PaulaMarquezM/Reci/tests/fotos_dificiles/gatorade_vidrio_473ml.jpeg

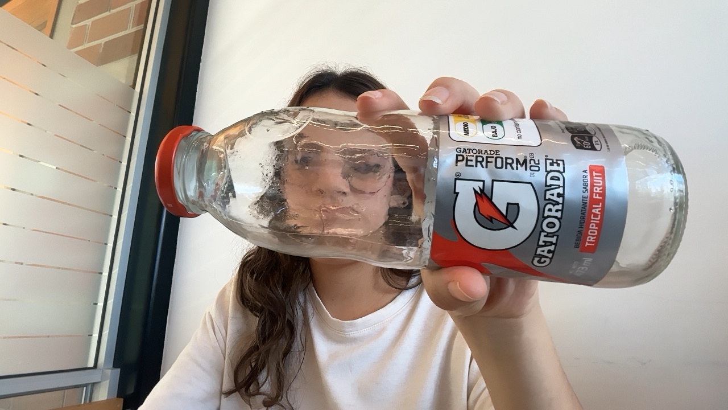
tests/fotos_dificiles/gatorade_vidrio_473ml.jpeg
