PaulaMarquezM/Reci/docs/product/PLAN.md

# Reci — Plan maestro

> Documento vivo. Se actualiza cada vez que cerramos una fase o cambiamos una decisión.
> Última actualización: 2026-07-22 · RECI2 integrado en el monorepo RECI; Fase 6 en curso, Fase 3 desbloqueada.

Este documento responde a tres preguntas en orden:

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

---

## Estado actual

### Hecho

- ✅ Acta de constitución aprobada (RECI-2026-PI v1.0).
- ✅ Repositorio principal: [`AxelJhostin/RECI`](https://github.com/AxelJhostin/RECI), con el historial de `PaulaMarquezM/Reci` importado.
- ✅ Monorepo: `web/`, `firmware/`, `services/`, `expert_system/`, `vision/` y `docs/`.
- ✅ `web/` scaffolded con **Next.js 16.2 + React 19 + Tailwind 4 + TypeScript** (App Router, Turbopack, `src/` layout). Build y lint limpios.
- ✅ Landing en español (`/`) con el branding Reci y las funcionalidades destacadas.
- ✅ Proyecto Supabase creado + schema v1 aplicado (12 tablas, triggers de puntos/racha, RLS).
- ✅ Cliente Supabase tipado (`web/src/lib/supabase/`), middleware de sesión, Auth magic link.
- ✅ Página `/login` y ruta `/app` protegida funcionando.
- ✅ 8 API routes implementadas (recycle, robot position, calls, coupons, compartments, face, vision/classify).
- ✅ Hardware final definido: Arduino Mega 2560 + ESP32-CAM (ver decisiones técnicas).
- ✅ Guía de conexiones de hardware documentada (`docs/product/CONEXIONES.md`), orden de ensamble por etapas para Leonela + Andrea.
- ✅ Las 5 pantallas de la app (home/mapa, llamar, historial, cupones, ajustes) conectadas a las API routes.
- ✅ Rediseño visual: tipografía Poppins, paleta cream/ink, mascota de Reci (`web/src/components/reci-mascot.tsx`).
- ✅ PWA instalable: `manifest.ts` + iconos generados dinámicamente con `next/og` (`icon-192.png`, `icon-512.png`, `icon-maskable-512.png` con safe-zone para Android adaptive icons).
- ✅ `services/vision` implementado (FastAPI + Claude/Gemini/OpenAI + heurísticas y sistema experto compartidos) y conectado a `/api/vision/classify`. Ver [`DECISION-SERVICIO-VISION.md`](DECISION-SERVICIO-VISION.md). Probado localmente; falta desplegarlo y probarlo con la ESP32-CAM física.

### En curso

- **Fase 5 completada** — backend y nube listos para integrarse con el hardware.
- **Fase 6 en curso** — pantallas y rediseño visual listos, PWA instalable lista. Falta: service worker (offline) y push notifications (marcado "soon" en `/app/ajustes`).
- **Fase 3 desbloqueada** — clasificación real disponible vía `services/vision`; falta desplegarlo y validar con fotos de la ESP32-CAM real (ver Fase 3 en el roadmap).

### Bloqueado / pendiente de decidir

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

> Resuelto: proveedor de mapas → **Leaflet + OSM** (implementado en Fase 6, sin token).

---

## Decisiones técnicas

Las decisiones del acta dejaban algunos "A o B" abiertos. Esto es lo que cerramos:

| Tema | Decisión | Razón |
| --- | --- | --- |
| Stack de la app | **Next.js PWA + Tailwind** | Un solo repo / stack para app + dashboard admin. Sin App Store/Play Store. La app vive como PWA instalable. |
| Stack del backend | **Supabase + Next.js API routes** | Auth, Postgres, Realtime y Storage en un solo proveedor. Sin servidor adicional que mantener. |
| Estructura del repo | Monorepo simple con carpetas por subsistema (`web/`, `firmware/`, `services/`, `expert_system/`, `vision/`) | Cada persona trabaja en su carpeta sin pisar al resto. Una sola fuente de verdad. |
| Versión de Next | **Next 16.2** (lo que instaló `create-next-app` hoy) | Tiene Turbopack estable y React 19. La doc local en `node_modules/next/dist/docs/` es la fuente autoritativa porque trae breaking changes vs Next 15. |
| Idioma de la UI | Español (Ecuador) | Es para el campus PUCE Manabí. Solo el código y los commits van en inglés. |
| Hosting | **Vercel** para el front + Supabase Cloud para DB | Deploy automático desde main. Free tier alcanza para el piloto. |
| **Cerebro del robot** | **Arduino Mega 2560** (era ESP32) | Más pines y memoria. Controla motores (2×L298N), servos (2×SG5010), sensores HC-SR04 y OLED. |
| **Sistema de visión** | **ESP32-CAM + OV2640** (era Raspberry Pi 4) | Sin Raspberry Pi. La ESP32-CAM captura imagen y la envía al cloud via WiFi. La IA corre en el servidor, no en el robot. |
| **Inferencia IA** | **Servicio Python aislado (`services/vision`), llamado desde `/api/vision/classify`** (era "dentro del Route Handler de Next.js con TF.js/ONNX") | Mismo patrón que `face-service`. Reutiliza directamente el sistema experto y los proveedores visuales compartidos y probados en este monorepo (117/117 pruebas del SE, 39/39 capturas reales con Claude) en vez de esperar al dataset propio + conversión a TF.js/ONNX. Ver [`DECISION-SERVICIO-VISION.md`](DECISION-SERVICIO-VISION.md). El MobileNetV2 propio con fotos de la ESP32-CAM sigue el plan, pero como mejora dentro de ese mismo servicio, no como bloqueante del Flujo A. |
| **Comunicación interna** | **UART Serial entre ESP32-CAM y Arduino Mega** (era UART Raspberry↔ESP32) | Protocolo `CMD:<accion>:<param>\n`. La ESP32-CAM recibe la decisión del cloud y la reenvía al Arduino. |
| **Despacho de llamadas al robot** | **Polling HTTP cada 3s** (era "webhook o canal Realtime") | El webhook necesita que el robot sea alcanzable desde internet, y va a estar detrás del NAT del WiFi del campus sin IP pública. Realtime es WebSocket+TLS+protocolo Phoenix sobre un ESP32-CAM que ya tiene la RAM comida por el framebuffer de la cámara: frágil. Polling es aburrido, funciona detrás de NAT y para "ven a buscarme" 3s de latencia nadie los nota. Contrato en [`API-ROBOT.md`](API-ROBOT.md). |
| **Posición del robot** | **Simbólica por punto, sin GPS** | No hay GPS en el BOM y Reci solo se mueve entre puntos fijos. Reporta `point_id` y el cloud resuelve lat/lng desde `robot_points`. Cero hardware nuevo y el mapa no cambia. Un NEO-6M daría 2–5m de error entre edificios y nada bajo techo: no vale la integración. |
| **Llave del robot** | **`ROBOT_API_KEY` propia** (era la service role key) | El firmware va grabado en un aparato que vive en el campus y se puede desarmar, así que esa llave hay que darla por comprometida. La service role key se salta todo el RLS: con ella se lee la tabla de usuarios entera. La llave del robot solo abre las 4 rutas del robot y se revoca sola. |
| **Energía** | **Power Bank 10,000 mAh** (lógica) + **LiPo** (motores) + **LM2596** (regulador) | Separación de circuitos para evitar interferencias y proteger la electrónica. |

---

## Roadmap por fases

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

### Fase 1 — Diseño y planificación · semanas 1–2

**Objetivo:** todo el equipo entiende lo mismo y existe arquitectura detallada antes de teclear código.

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

### Fase 2 — Prototipo físico base · semanas 3–4

**Objetivo:** un chasis que se mueve entre dos puntos sin compuertas ni IA.

- [ ] **Leonela** · ensamble chasis + ruedas + 2×L298N + 4 motorreductores TT
- [ ] **Leonela** · firmware Arduino Mega base: `forward / backward / stop / turn`
- [ ] **Leonela** · sensores HC-SR04 con parada automática a ≤ 20 cm
- [ ] **Leonela** · pantalla OLED 0.96" I2C mostrando estado del robot — la cara de Reci ya está escrita en `firmware/arduino-mega/Display.h` (`CMD:FACE:<estado>`), falta probarla contra el OLED real
- [ ] **Andrea** · Power Bank (lógica) + LiPo (motores) + LM2596 (regulador) + cableado
- [ ] **Andrea** · prueba de movimiento punto-a-punto sobre cinta marcada

### Fase 3 — Sistema IA y experto · semanas 4–6

**Objetivo:** clasificación vidrio/plástico ≥ 85% en condiciones del campus, corriendo en el cloud.

- [x] **`services/vision` implementado** — FastAPI + Claude/Gemini/OpenAI + heurísticas y sistema experto compartidos, probado localmente (auth, validación, manejo de errores, mapeo a `MaterialType`). Ver [`DECISION-SERVICIO-VISION.md`](DECISION-SERVICIO-VISION.md).
- [x] **`web/src/app/api/vision/classify/route.ts`** — stub reemplazado, llama a `services/vision` vía `web/src/lib/vision/service.ts` (mismo patrón que `face/service.ts`). Falla segura a `desconocido` si el servicio no responde.
- [ ] **Axel/Andrea** · desplegar `services/vision` en un host accesible desde Vercel y configurar `VISION_SERVICE_URL` / `VISION_SERVICE_API_KEY` en el panel de Vercel
- [ ] **Axel + Paula** · prueba end-to-end: ESP32-CAM → `POST /api/vision/classify` → `services/vision` → respuesta JSON, con fotos reales de la ESP32-CAM
- [ ] **Axel** · recalibrar `visual_heuristics.py` con fotos reales de la ESP32-CAM (320×240) — los umbrales actuales vienen de fotos de mayor resolución del laboratorio de IA
- [ ] **Axel** (mejora, no bloquea) · captura del dataset propio (≥ 500 imgs por clase) en el campus con ESP32-CAM, para entrenar un MobileNetV2 que corra como primer voto dentro de `vision-service` — optimización de costo/latencia sobre Claude/Gemini, no reemplazo

### Fase 4 — Integración Reci físico · semanas 6–8

**Objetivo:** el robot completo funciona con el cloud (ESP32-CAM → cloud → Arduino Mega).

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

### Fase 5 — Backend y nube · semanas 7–10

**Objetivo:** API y base de datos listas para que la app y el robot conversen.

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

### Fase 6 — App móvil · semanas 9–12

**Objetivo:** la app es usable end-to-end.

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

### Fase 7 — Integración end-to-end · semanas 12–14

**Objetivo:** los 3 flujos (A, B, C del acta) funcionan sin intervención manual.

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

### Fase 8 — Piloto en campus + cierre · semanas 14–16

**Objetivo:** Reci opera en el campus durante una semana y entregamos el proyecto.

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

---

## Backlog por subsistema

### Cloud + App/PWA · Paula

Schema mínimo v1 a crear en Supabase (Fase 5):

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

Endpoints REST mínimos (Next.js Route Handlers en `web/src/app/api/`):

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

### Firmware · Leonela + Andrea

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

**ESP32-CAM** (C++ Arduino, AI Thinker):
- Al recibir `C` por el Monitor Serial: toma 3 fotos con flash (`kFlashLedPin`), llama a `POST /api/vision/classify` por cada una (`record_event: false`) y vota mayoría localmente.
- Registra el resultado final una sola vez con `POST /api/events/recycle`; si la respuesta trae `claim_code`, lo reenvía al Mega como `CMD:QR:<code>`.
- Reconocimiento facial (saludo) es un flujo aparte, contra `/api/face/recognize` — ver `services/face`.

### IA · Axel

- Servicio aislado `services/vision` (FastAPI), llamado desde `web/src/app/api/vision/classify/route.ts` — mismo patrón que `services/face`. Ver [`DECISION-SERVICIO-VISION.md`](DECISION-SERVICIO-VISION.md).
- Clasificación con Claude/Gemini/OpenAI (9 atributos) + heurísticas compartidas, probada en este monorepo (117/117 pruebas del sistema experto, 39/39 capturas reales).
- Sistema experto de 193 reglas (CF MYCIN, meta-reglas, forward + backward chaining) sobre los atributos extraídos — no reglas IF-THEN simples sobre un solo umbral.
- Pendiente (mejora, no bloqueante): MobileNet v2 propio entrenado con dataset de la ESP32-CAM, corriendo dentro de `vision-service` como primer voto (reduce costo/latencia de las llamadas a Claude/Gemini).
- Sin procesamiento local en el robot — toda la inferencia ocurre en el cloud (la ESP32-CAM solo captura y envía).

---

## Métricas de éxito (recordatorio del acta)

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

---

## Próximos pasos inmediatos

Por orden:

1. **Paula** — 🔴 **levantar los puntos fijos del campus con el Decanato y cargarlos en `robot_points`.** Es barato (una tarde con un GPS de celular) y desbloquea todo el Flujo B, que hoy está escrito y sin poder probarse.
2. **Paula** — aplicar `20260716000001_robot_calls_dispatch.sql` en Supabase y poner `ROBOT_API_KEY` en Vercel.
3. **Paula** — la app reacciona por Realtime a "Reci aceptó / llegó" en `/app/llamar`.
4. **Andrea** — cliente HTTP en la ESP32-CAM contra [`API-ROBOT.md`](API-ROBOT.md); el contrato ya está cerrado, no hace falta esperar a la IA.
5. **Paula** — service worker (PWA offline), opt-in facial y push notifications (cierre de Fase 6).
6. **Axel/Andrea** — desplegar `services/vision` en un host accesible desde Vercel y configurar `VISION_SERVICE_URL`/`VISION_SERVICE_API_KEY`; ya no bloquea al Flujo A (el servicio existe y está probado localmente, ver [`DECISION-SERVICIO-VISION.md`](DECISION-SERVICIO-VISION.md)), pero falta correrlo con fotos reales de la ESP32-CAM.
7. **Axel** — captura del dataset propio con ESP32-CAM y transfer learning de MobileNet v2 (Fase 3), ahora es una mejora de costo/latencia dentro de `vision-service`, no el bloqueante del Flujo A.
8. **Leonela + Andrea** — ensamble físico siguiendo `docs/product/CONEXIONES.md` (Fase 2 → Fase 4).
