PaulaMarquezM/Reci/firmware/esp32-cam/ReciEsp32Cam/ReciHttpClient.h

// ============================================================
// RECI · Cliente HTTP/HTTPS para la ESP32-CAM
// ============================================================

#ifndef RECI_HTTP_CLIENT_H
#define RECI_HTTP_CLIENT_H

#include <Arduino.h>
#include <WiFiClient.h>
#include <WiFiClientSecure.h>

// GTS Root R1, raíz vigente de la cadena TLS usada por *.vercel.app.
// Fuente oficial: https://pki.goog/roots.pem
static const char kReciTlsRootCa[] PROGMEM = R"RECI_CERT(
-----BEGIN CERTIFICATE-----
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
bP6MvPJwNQzcmRk13NfIRmPVNnGuV/u3gm3c
-----END CERTIFICATE-----
)RECI_CERT";

class ReciHttpClient {
 public:
  explicit ReciHttpClient(const String& url) {
    if (url.startsWith("https://")) {
      secureClient_.setCACert(kReciTlsRootCa);
      client_ = &secureClient_;
    } else {
      client_ = &plainClient_;
    }
  }

  NetworkClient& get() { return *client_; }

 private:
  WiFiClient plainClient_;
  NetworkClientSecure secureClient_;
  NetworkClient* client_ = nullptr;
};

#endif  // RECI_HTTP_CLIENT_H
