PaulaMarquezM/Reci/firmware/arduino-mega/ReciRutaDemo/ReciRutaDemo.ino

// ============================================================
// RECI · Ruta demo sin sensores de linea
// Arduino Mega 2560 + 2 L298N + 4 motores TT
//
// Ruta recta de demostración: BASE <-> P1 <-> P2
// RECI no gira: hacia P1/P2 avanza y hacia BASE regresa en reversa por la
// misma línea. En reversa frena con el ultrasónico trasero (D26/D27).
//
// IMPORTANTE
// - Este sketch NO se mueve al encender.
// - Coloca siempre el robot en BASE antes de probar una ruta.
// - Prueba primero con las ruedas levantadas.
// - Ajusta los tres tiempos de ruta despues de medir el circuito real.
// ============================================================

#include <Wire.h>
#include <Adafruit_GFX.h>
#include <Adafruit_SSD1306.h>
#include <LiquidCrystal_I2C.h>
#include <Servo.h>
#include <EEPROM.h>
#include <qrcode.h>

namespace {

// Mapa confirmado por RECI_Guia_Armado_Electronico.docx.
constexpr uint8_t kIzqIn1 = 5;
constexpr uint8_t kIzqIn2 = 6;
constexpr uint8_t kIzqIn3 = 7;
constexpr uint8_t kIzqIn4 = 8;
constexpr uint8_t kDerIn1 = 9;
constexpr uint8_t kDerIn2 = 10;
constexpr uint8_t kDerIn3 = 11;
constexpr uint8_t kDerIn4 = 13;

// Sentido de cada motor por separado. Si con F una rueda gira hacia atrás,
// cambia SOLO la constante de ese par de pines. Para saber qué rueda mueve
// cada par, escribe MOTORES en el Monitor Serial (con las ruedas levantadas).
constexpr bool kInvertirIzqA = true;   // D5/D6
constexpr bool kInvertirIzqB = true;   // D7/D8
constexpr bool kInvertirDerA = false;  // D9/D10
constexpr bool kInvertirDerB = true;   // D11/D13
constexpr unsigned long kPruebaMotorMs = 2000UL;

// Compuerta única: un solo servo en D3 inclina la bandeja hacia un lado.
// Plástico gira a la IZQUIERDA y vidrio a la DERECHA; luego vuelve al centro.
// CALIBRACION: si en el robot real gira al lado contrario, intercambia
// kServoIzquierda y kServoDerecha. Ajusta los ángulos con ReciServosTest.
constexpr uint8_t kServoCompuertaPin = 3;
constexpr uint8_t kServoCentro = 65;     // en 90 quedaba girado a la derecha
constexpr uint8_t kServoIzquierda = 20;  // 30 se quedaba corto (prueba 2026-11-08)
constexpr uint8_t kServoDerecha = 110;  // 100 a veces no alcanzaba a mover la bandeja (prueba 2026-11-08)
constexpr unsigned long kCompuertaAbiertaMs = 2000UL;
// Después de reciclar, la LCD pide escanear el QR y la OLED lo muestra este
// tiempo; luego RECI vuelve solo al saludo, listo para otra botella.
constexpr unsigned long kMostrarPremiosMs = 10000UL;
// "No estoy seguro" y los rechazos (lata, papel) se ven este tiempo.
constexpr unsigned long kMostrarAvisoMs = 5000UL;

Servo servoCompuerta;
bool reposoPendiente = false;
unsigned long volverAReposoEn = 0;

// OLED SSD1306 128x64 por I2C: Mega SDA=20, SCL=21.
constexpr uint8_t kDireccionOled = 0x3C;
// El firmware completo atiende interrupciones de servos y UART; 25 ms evita
// falsos timeouts sin permitir que un bus I2C averiado congele el robot.
constexpr unsigned long kI2cTimeoutUs = 25000UL;
// El escaner y los dos modulos responden de forma estable a la velocidad
// I2C estandar. El bus compartido no es fiable a 400 kHz con este cableado.
constexpr unsigned long kI2cClockHz = 100000UL;
Adafruit_SSD1306 oled(128, 64, &Wire, -1);
bool oledDisponible = false;

// LCD 16x2 I2C: comparte SDA=20 y SCL=21 con la OLED.
// La mayoría de estos módulos usan 0x27; si no muestra texto, se confirma
// la dirección con un escáner I2C antes de cambiar esta constante.
constexpr uint8_t kDireccionLcd = 0x27;
LiquidCrystal_I2C lcd(kDireccionLcd, 16, 2);
bool lcdDisponible = false;

enum class CaraReci : uint8_t { SinDibujar, Lista, Movimiento, Feliz, Alerta };
CaraReci caraActual = CaraReci::SinDibujar;
bool qrVisible = false;

// HC-SR04 frontal: freno de seguridad mientras RECI esta en ruta.
// Cableado real (prueba 2026-11-08, tapando cada sensor con la mano): el
// sensor del frente responde en D26/D27. El de adentro y el lateral no
// respondieron en ningún pin: revisar sus cables TRIG/ECHO/5V/GND.
constexpr uint8_t kTrigFrontal = 26;
constexpr uint8_t kEchoFrontal = 27;
constexpr unsigned long kDistanciaSeguraCm = 20;
constexpr unsigned long kRevisionObstaculoMs = 100UL;
constexpr unsigned long kEchoTimeoutUs = 25000UL;
// Tras detectar un obstáculo, el frente debe quedar libre este tiempo antes
// de continuar solo. Evita que una lectura aislada haga arrancar a RECI.
constexpr unsigned long kFrenteLibreAntesDeReanudarMs = 1000UL;

// HC-SR04 trasero (el tercer ultrasónico): mira hacia atrás y frena a RECI
// cuando regresa en reversa. Si no responde (sin cable), la reversa avanza
// sin freno, así que móntalo antes de usar BASE desde la app.
constexpr uint8_t kTrigTrasero = 22;
constexpr uint8_t kEchoTrasero = 23;

// HC-SR04 interno (el que estaba al costado): mira el hueco donde se deja la
// botella. Solo se busca botella durante kBuscarBotellaTrasPirMs después de
// que el PIR ve a alguien; así el sensor no dispara fotos con el hueco vacío.
// CALIBRACION: con la botella puesta, BOTELLA? debe dar <= kDistanciaBotellaCm.
constexpr uint8_t kTrigBotella = 24;
constexpr uint8_t kEchoBotella = 25;
// Hueco vacío mide ~11 cm (sensor en D24/D25, prueba 2026-11-08). Una
// botella acostada lo baja a ~4-7 cm; 8 cm deja margen sin disparar en vacío.
constexpr long kDistanciaBotellaCm = 8;
constexpr unsigned long kBuscarBotellaTrasPirMs = 60000UL;
// Por debajo de ~3 cm el HC-SR04 no mide bien: se descarta como ruido.
constexpr long kDistanciaBotellaMinCm = 3;
constexpr unsigned long kRevisionBotellaMs = 150UL;
// La botella debe quedarse quieta este tiempo; una mano que pasa no cuenta.
constexpr unsigned long kBotellaEstableMs = 800UL;
// Tras una lectura, el hueco debe vaciarse y esperar esto antes de otra.
constexpr unsigned long kEsperaEntreBotellasMs = 10000UL;

// PIR de bienvenida: el esquema de RECI conecta OUT al pin 28 del Mega.
// Solo genera un evento de presencia cuando el robot está detenido; nunca
// inicia un movimiento ni concede puntos por sí solo.
constexpr uint8_t kPirPin = 28;
constexpr unsigned long kPirWarmupMs = 30000UL;
constexpr unsigned long kEsperaPresenciaMs = 10000UL;
// Tras confirmar la llegada, la ESP actualiza la llamada, la posición y el
// saludo. Esperamos antes de emitir PRESENCIA para que esos HTTP/pulsos no se
// solapen con el inicio automático de la cámara.
constexpr unsigned long kEsperaPresenciaTrasLlegadaMs = 6000UL;

// CALIBRACION: reemplaza 0 por el tiempo medido en milisegundos.
// Mide cada tramo tres veces y usa el promedio. Los dos tramos son rectos,
// siempre en la dirección BASE -> P1 -> P2.
constexpr unsigned long kBaseAP1Ms = 8000UL;
constexpr unsigned long kP1AP2Ms = 8000UL;

// El Monitor Serial USB se mantiene en 9600 para las pruebas manuales.
constexpr unsigned long kUsbSerialBaud = 9600UL;
// El regreso Mega -> ESP usa pulsos LOW por D16 hacia GPIO13. Es el mismo
// cable con divisor que antes llevaba UART, pero los pulsos son mucho más
// tolerantes al cableado largo y al ruido eléctrico del robot.
constexpr unsigned long kPulsoMegaLlegadaP1Ms = 1800UL;
constexpr unsigned long kPulsoMegaLlegadaP2Ms = 2400UL;
constexpr unsigned long kPulsoMegaPresenciaMs = 3000UL;
constexpr unsigned long kPulsoMegaPongMs = 3600UL;
// Confirmación corta de que el Mega aceptó la orden y escribió el ángulo del
// servo. La ESP espera esta confirmación antes de registrar puntos.
constexpr unsigned long kPulsoMegaCompuertaConfirmadaMs = 800UL;
// La ESP mantiene 300 ms de separación después de enviar @P/@V. Retrasar la
// confirmación garantiza que ya esté escuchando cuando empiece el pulso.
constexpr unsigned long kRetrasoConfirmacionCompuertaMs = 400UL;
constexpr unsigned long kSeparacionPulsoMegaMs = 200UL;
// Diagnóstico sin multímetro: conecta un jumper desde el mismo cable
// ESP GPIO14 -> Mega D17 hacia A8. A8 es solo entrada, por lo que no altera
// la comunicación ni entrega voltaje a la ESP32-CAM.
constexpr uint8_t kEspTxSensePin = A8;
// Para comparar contra la alimentación real de la ESP, conecta también
// ESP 3V3 -> Mega A9. A9 es únicamente entrada.
constexpr uint8_t kEsp3v3SensePin = A9;
constexpr uint8_t kMegaTx2Pin = 16;
// ESP GPIO14 llega directo a D17. En lugar de decodificarlo como UART, el
// Mega mide pulsos HIGH de varios cientos de milisegundos. Así una trama
// corrupta no puede convertirse en una orden del robot.
constexpr uint8_t kPulsoEspPin = 17;
// false = sin ESP32-CAM: la cámara de la compu (camara-pc/) manda las mismas
// órdenes por USB. Con D17 desconectado el pin queda flotando y el ruido se
// leería como órdenes falsas (incluso rutas), así que no se escucha.
constexpr bool kEsp32CamConectada = false;
constexpr unsigned long kIgnorarPulsosAlArrancarMs = 3500UL;
constexpr unsigned long kToleranciaPulsoMs = 120UL;
// Un cable largo y la conmutacion de motores/servos pueden producir caidas
// LOW muy breves dentro de un pulso valido. Solo damos el pulso por terminado
// cuando D17 permanece LOW durante este tiempo; asi no se parte una orden de
// 900 ms en varios pulsos pequenos. La separacion real de la ESP es 300 ms.
constexpr unsigned long kFinPulsoEspEstableMs = 140UL;
// Los caracteres del QR usan separaciones de 120 ms, por eso durante esa
// fase aplicamos un filtro menor que no una dos caracteres consecutivos.
constexpr unsigned long kFinPulsoQrEstableMs = 45UL;
constexpr unsigned long kPulsoAnalizarMs = 300UL;
constexpr unsigned long kPulsoDesconocidoMs = 600UL;
constexpr unsigned long kPulsoPlasticoMs = 900UL;
constexpr unsigned long kPulsoVidrioMs = 1200UL;
constexpr unsigned long kPulsoP1Ms = 1500UL;
constexpr unsigned long kPulsoP2Ms = 1800UL;
constexpr unsigned long kPulsoSaludoMs = 2100UL;
constexpr unsigned long kPulsoBotellaMs = 2400UL;
constexpr unsigned long kPulsoListoMs = 2700UL;
constexpr unsigned long kPulsoErrorMs = 3000UL;
constexpr unsigned long kPulsoPuntosDirectosMs = 3300UL;
constexpr unsigned long kPulsoPuntosAppMs = 3600UL;
constexpr unsigned long kPulsoGraciasMs = 3900UL;
constexpr unsigned long kPulsoPruebaMs = 4200UL;
// Transporte del claim_code real hacia la OLED. El primer pulso abre una
// recepción de ocho caracteres; los ocho siguientes codifican 0-9 y A-Z por
// duración. Solo se interpreta esta familia mientras la recepción QR está
// activa, así nunca se convierte en órdenes de ruta o compuerta.
constexpr unsigned long kPulsoQrInicioMs = 4500UL;
constexpr unsigned long kPulsoQrCaracterBaseMs = 180UL;
constexpr unsigned long kPulsoQrCaracterPasoMs = 60UL;
constexpr unsigned long kToleranciaQrCaracterMs = 25UL;
constexpr unsigned long kTimeoutRecepcionQrMs = 3000UL;
constexpr char kAlfabetoCodigoQr[] = "0123456789ABCDEFGHIJKLMNOPQRSTUVWXYZ";
constexpr uint8_t kLongitudCodigoQr = 8;
constexpr uint8_t kEspTxSenseSamples = 32;
constexpr uint16_t kAdcFullScale = 1023U;
// Los mensajes de la ESP32 incluyen, por ejemplo,
// "CMD:LCD:Hola, Pau|Soy RECI". Deja espacio suficiente para el saludo
// sin alterar los comandos cortos de movimiento.
constexpr size_t kComandoMax = 64;

enum class Punto : uint8_t { Desconocido, Base, P1, P2 };
enum class Modo : uint8_t { Detenido, ManualAdelante, ManualAtras, ManualIzquierda,
                            ManualDerecha, EnRuta, Emergencia };
enum class CompuertaActiva : uint8_t { Ninguna, Vidrio, Plastico };

// La demostración se enciende con RECI físicamente colocado en BASE. Guardar
// ese estado desde el arranque permite que una llamada de la app salga sola,
// sin requerir escribir SET:BASE en el Monitor Serial. No mueve motores.
// Si alguna vez se enciende fuera de BASE, confirma la posición real con
// SET:P1 o SET:P2 antes de aceptar una llamada.
Punto puntoActual = Punto::Base;
Punto destino = Punto::Desconocido;
Modo modo = Modo::Detenido;
unsigned long terminaTramoEn = 0;
unsigned long ultimoChequeoObstaculo = 0;
unsigned long tiempoRestantePausaMs = 0;
unsigned long frenteLibreDesde = 0;
unsigned long proximaPresenciaPermitidaEn = 0;
bool pirListoParaNuevoEvento = false;
unsigned long ultimoChequeoBotella = 0;
unsigned long buscarBotellaHasta = 0;
unsigned long botellaPresenteDesde = 0;
unsigned long proximaBotellaPermitidaEn = 0;
bool huecoVacioDesdeUltimaBotella = true;
CompuertaActiva compuertaActiva = CompuertaActiva::Ninguna;
unsigned long cerrarCompuertaEn = 0;
Punto destinoPendienteCompuerta = Punto::Desconocido;
bool pulsoEspActivo = false;
unsigned long inicioPulsoEspEn = 0;
bool finPulsoEspPendiente = false;
unsigned long inicioFinPulsoEspEn = 0;
unsigned long habilitarPulsosEspEn = 0;
// Salida Mega D16 -> ESP GPIO13 sin bloqueos. Antes, un evento PRESENCIA
// mantenia al Mega dentro de delay(3000) y durante ese tiempo podia perder
// por completo la orden @P/@V que abre la compuerta.
bool pulsoMegaSalidaActivo = false;
unsigned long pulsoMegaSalidaTerminaEn = 0;
unsigned long pulsoMegaSalidaDisponibleEn = 0;
unsigned long pulsoMegaSalidaDuracion = 0;
const __FlashStringHelper* pulsoMegaSalidaEtiqueta = nullptr;
bool pulsoMegaSalidaPendiente = false;
unsigned long pulsoMegaPendienteDuracion = 0;
const __FlashStringHelper* pulsoMegaPendienteEtiqueta = nullptr;
bool recibiendoCodigoQr = false;
char codigoQrRecibido[kLongitudCodigoQr + 1] = {};
uint8_t longitudCodigoQrRecibido = 0;
unsigned long ultimoCaracterQrEn = 0;

struct EntradaSerial {
  char comando[kComandoMax + 1] = {};
  size_t longitud = 0;
  // Si una trama llega dañada o supera el límite, se ignora hasta el salto
  // de línea. Así sus bytes restantes no se interpretan como comandos nuevos.
  bool descartarHastaNuevaLinea = false;
};

// El USB conserva un buffer de texto para las pruebas manuales.
EntradaSerial entradaUsb;

bool i2cResponde(uint8_t direccion) {
  Wire.clearWireTimeoutFlag();
  Wire.beginTransmission(direccion);
  const uint8_t estado = Wire.endTransmission();
  const bool expiro = Wire.getWireTimeoutFlag();
  Serial.print(F("DIAG I2C 0x"));
  if (direccion < 0x10) Serial.print('0');
  Serial.print(direccion, HEX);
  Serial.print(F(": estado="));
  Serial.print(estado);
  Serial.print(F(", timeout="));
  Serial.println(expiro ? F("si") : F("no"));
  Wire.clearWireTimeoutFlag();
  return !expiro && estado == 0;
}

void diagnosticarLineasI2c(const __FlashStringHelper* etapa) {
  Serial.print(F("DIAG LINEAS "));
  Serial.print(etapa);
  Serial.print(F(": SDA="));
  Serial.print(digitalRead(SDA));
  Serial.print(F(", SCL="));
  Serial.print(digitalRead(SCL));
  Serial.print(F(", IRQ="));
  Serial.println((SREG & _BV(SREG_I)) != 0 ? F("on") : F("off"));
}

void mostrarLcd(const char* linea1, const char* linea2) {
  if (!lcdDisponible) return;
  lcd.clear();
  lcd.setCursor(0, 0);
  lcd.print(linea1);
  lcd.setCursor(0, 1);
  lcd.print(linea2);
}

void mostrarRutaEnLcd(const char* accion, Punto punto) {
  if (punto == Punto::P1) {
    mostrarLcd(accion, "Punto 1");
  } else if (punto == Punto::P2) {
    mostrarLcd(accion, "Punto 2");
  } else {
    mostrarLcd(accion, "BASE");
  }
}

void informar(const __FlashStringHelper* texto);

// La carita se dibuja solo cuando cambia el estado; así no frena la lectura
// del ultrasónico ni el recorrido por estar redibujando constantemente.
// Se usan líneas y formas compactas, no arcos superpuestos: en esta OLED los
// tres arcos anteriores parecían rayas cuando se veía desde lejos.
void mostrarCara(CaraReci cara) {
  if (!oledDisponible || cara == caraActual) return;

  qrVisible = false;
  caraActual = cara;
  oled.clearDisplay();
  oled.setTextColor(SSD1306_WHITE);

  if (cara == CaraReci::Movimiento) {
    // Mira hacia delante mientras avanza.
    oled.fillRoundRect(27, 15, 25, 18, 7, SSD1306_WHITE);
    oled.fillRoundRect(76, 15, 25, 18, 7, SSD1306_WHITE);
    oled.fillCircle(44, 24, 4, SSD1306_BLACK);
    oled.fillCircle(93, 24, 4, SSD1306_BLACK);
    oled.drawLine(51, 48, 77, 48, SSD1306_WHITE);
    oled.drawLine(51, 49, 77, 49, SSD1306_WHITE);
  } else if (cara == CaraReci::Feliz) {
    // Ojos ^ ^ y una sonrisa limpia: llegó o detectó a una persona.
    oled.drawLine(30, 29, 39, 20, SSD1306_WHITE);
    oled.drawLine(39, 20, 48, 29, SSD1306_WHITE);
    oled.drawLine(80, 29, 89, 20, SSD1306_WHITE);
    oled.drawLine(89, 20, 98, 29, SSD1306_WHITE);
    oled.drawLine(47, 43, 55, 51, SSD1306_WHITE);
    oled.drawLine(55, 51, 73, 51, SSD1306_WHITE);
    oled.drawLine(73, 51, 81, 43, SSD1306_WHITE);
    oled.drawLine(47, 44, 55, 52, SSD1306_WHITE);
    oled.drawLine(55, 52, 73, 52, SSD1306_WHITE);
    oled.drawLine(73, 52, 81, 44, SSD1306_WHITE);
  } else if (cara == CaraReci::Alerta) {
    // Ojos redondos y boca "o": hay un obstáculo al frente.
    oled.fillCircle(39, 23, 9, SSD1306_WHITE);
    oled.fillCircle(89, 23, 9, SSD1306_WHITE);
    oled.fillCircle(39, 23, 3, SSD1306_BLACK);
    oled.fillCircle(89, 23, 3, SSD1306_BLACK);
    oled.drawRoundRect(57, 40, 14, 16, 6, SSD1306_WHITE);
  } else {
    // Cara tranquila mientras espera en BASE/P1/P2.
    oled.fillRoundRect(27, 14, 25, 20, 8, SSD1306_WHITE);
    oled.fillRoundRect(76, 14, 25, 20, 8, SSD1306_WHITE);
    oled.fillCircle(39, 24, 4, SSD1306_BLACK);
    oled.fillCircle(88, 24, 4, SSD1306_BLACK);
    oled.drawLine(48, 43, 55, 50, SSD1306_WHITE);
    oled.drawLine(55, 50, 73, 50, SSD1306_WHITE);
    oled.drawLine(73, 50, 80, 43, SSD1306_WHITE);
    oled.drawLine(48, 44, 55, 51, SSD1306_WHITE);
    oled.drawLine(55, 51, 73, 51, SSD1306_WHITE);
    oled.drawLine(73, 51, 80, 44, SSD1306_WHITE);
  }

  oled.display();
}

void mostrarQrReal(const char* codigo) {
  if (!oledDisponible || codigo == nullptr || codigo[0] == '\0') return;

  // Un claim_code tiene 8 caracteres: cabe en QR version 1 con correccion
  // baja. Se dibuja negro sobre blanco y con margen de 4 modulos para que
  // la camara de la PWA pueda leerlo sin invertir la imagen.
  constexpr uint8_t kQrVersion = 1;
  constexpr uint8_t kEscala = 2;
  constexpr uint8_t kMargenModulos = 4;
  constexpr uint8_t kQrBufferBytes = 56;
  uint8_t datosQr[kQrBufferBytes] = {};
  QRCode qr;

  if (qrcode_initText(&qr, datosQr, kQrVersion, ECC_LOW, codigo) != 0) {
    informar(F("ERROR: no se pudo generar el QR."));
    return;
  }

  const uint8_t ladoTotal = (qr.size + 2 * kMargenModulos) * kEscala;
  const int16_t origenX = (oled.width() - ladoTotal) / 2;
  const int16_t origenY = (oled.height() - ladoTotal) / 2;

  oled.clearDisplay();
  oled.fillRect(origenX, origenY, ladoTotal, ladoTotal, SSD1306_WHITE);
  for (uint8_t y = 0; y < qr.size; ++y) {
    for (uint8_t x = 0; x < qr.size; ++x) {
      if (!qrcode_getModule(&qr, x, y)) continue;
      oled.fillRect(origenX + (x + kMargenModulos) * kEscala,
                    origenY + (y + kMargenModulos) * kEscala,
                    kEscala, kEscala, SSD1306_BLACK);
    }
  }
  oled.display();
  qrVisible = true;
  caraActual = CaraReci::SinDibujar;
}

// Potencia PWM por lado (0-255). Los motores no son idénticos: si RECI se
// va de lado, se baja la del lado más rápido con VEL:I:n o VEL:D:n. Se
// guarda en EEPROM porque abrir el puerto USB reinicia el Mega.
constexpr int kEepromPotencia = 0;      // firma + izq + der
constexpr uint8_t kFirmaPotencia = 0xA5;
uint8_t potenciaIzq = 255;
uint8_t potenciaDer = 255;

void cargarPotencias() {
  if (EEPROM.read(kEepromPotencia) != kFirmaPotencia) return;
  potenciaIzq = EEPROM.read(kEepromPotencia + 1);
  potenciaDer = EEPROM.read(kEepromPotencia + 2);
}

void guardarPotencias() {
  EEPROM.update(kEepromPotencia, kFirmaPotencia);
  EEPROM.update(kEepromPotencia + 1, potenciaIzq);
  EEPROM.update(kEepromPotencia + 2, potenciaDer);
}

void informarPotencias() {
  Serial.print(F("RECI: potencia izq="));
  Serial.print(potenciaIzq);
  Serial.print(F(" der="));
  Serial.println(potenciaDer);
}

// D5-D13 son pines PWM en el Mega: el pin activo recibe la potencia y el
// otro queda en LOW.
void escribirMotor(uint8_t pinA, uint8_t pinB, bool adelante, bool invertir,
                   uint8_t potencia = 255) {
  const bool sentido = invertir ? !adelante : adelante;
  if (sentido) {
    digitalWrite(pinB, LOW);
    analogWrite(pinA, potencia);
  } else {
    digitalWrite(pinA, LOW);
    analogWrite(pinB, potencia);
  }
}

void escribirLadoIzquierdo(bool adelante) {
  escribirMotor(kIzqIn1, kIzqIn2, adelante, kInvertirIzqA, potenciaIzq);
  escribirMotor(kIzqIn3, kIzqIn4, adelante, kInvertirIzqB, potenciaIzq);
}

void escribirLadoDerecho(bool adelante) {
  escribirMotor(kDerIn1, kDerIn2, adelante, kInvertirDerA, potenciaDer);
  escribirMotor(kDerIn3, kDerIn4, adelante, kInvertirDerB, potenciaDer);
}

void detenerMotores();

// Diagnóstico con las ruedas levantadas: mueve un solo par de pines
// "adelante" durante 2 s para identificar qué rueda controla cada par.
void probarMotores() {
  struct Par { uint8_t a; uint8_t b; bool invertir; const char* nombre; };
  const Par pares[] = {
    {kIzqIn1, kIzqIn2, kInvertirIzqA, "D5/D6   (kInvertirIzqA)"},
    {kIzqIn3, kIzqIn4, kInvertirIzqB, "D7/D8   (kInvertirIzqB)"},
    {kDerIn1, kDerIn2, kInvertirDerA, "D9/D10  (kInvertirDerA)"},
    {kDerIn3, kDerIn4, kInvertirDerB, "D11/D13 (kInvertirDerB)"},
  };
  for (const Par& par : pares) {
    Serial.print(F("MOTOR "));
    Serial.print(par.nombre);
    Serial.println(F(": adelante 2 s. Mira que rueda gira y hacia donde."));
    escribirMotor(par.a, par.b, true, par.invertir);
    delay(kPruebaMotorMs);
    detenerMotores();
    delay(1000);
  }
  Serial.println(F("MOTORES: prueba terminada."));
}

void detenerMotores() {
  const uint8_t pines[] = {kIzqIn1, kIzqIn2, kIzqIn3, kIzqIn4,
                            kDerIn1, kDerIn2, kDerIn3, kDerIn4};
  for (uint8_t pin : pines) digitalWrite(pin, LOW);
}

void avanzar() {
  escribirLadoIzquierdo(true);
  escribirLadoDerecho(true);
}

void retroceder() {
  escribirLadoIzquierdo(false);
  escribirLadoDerecho(false);
}

void girarIzquierda() {
  escribirLadoIzquierdo(false);
  escribirLadoDerecho(true);
}

void girarDerecha() {
  escribirLadoIzquierdo(true);
  escribirLadoDerecho(false);
}

const __FlashStringHelper* nombrePunto(Punto punto) {
  switch (punto) {
    case Punto::Base: return F("BASE");
    case Punto::P1: return F("P1");
    case Punto::P2: return F("P2");
    default: return F("DESCONOCIDO");
  }
}

void informar(const __FlashStringHelper* texto) {
  Serial.print(F("RECI: "));
  Serial.println(texto);
}

void informarPunto(const __FlashStringHelper* prefijo, Punto punto) {
  Serial.print(F("RECI: "));
  Serial.print(prefijo);
  Serial.println(nombrePunto(punto));
}

void cerrarCompuertas() {
  servoCompuerta.write(kServoCentro);
  compuertaActiva = CompuertaActiva::Ninguna;
}

// Programa el regreso al saludo inicial (borra QR y avisos de la pantalla).
void programarReposo(unsigned long enMs) {
  reposoPendiente = true;
  volverAReposoEn = millis() + enMs;
}

void cancelarReposo() {
  reposoPendiente = false;
}

void actualizarReposo() {
  if (!reposoPendiente) return;
  if (static_cast<long>(millis() - volverAReposoEn) < 0) return;
  reposoPendiente = false;
  caraActual = CaraReci::SinDibujar;  // fuerza a redibujar aunque haya un QR
  mostrarCara(CaraReci::Lista);
  mostrarLcd("Hola, soy RECI", "Recicla y gana");
  informar(F("PANTALLA: de vuelta al saludo."));
}

void irAPunto(Punto solicitado);

bool abrirCompuerta(CompuertaActiva solicitada) {
  // Las tapas solo se abren cuando RECI está quieto en una parada.
  if (modo != Modo::Detenido) {
    informar(F("No abro compuerta mientras RECI se mueve."));
    return false;
  }
  if (compuertaActiva != CompuertaActiva::Ninguna) {
    informar(F("Una compuerta ya esta abierta."));
    return false;
  }

  if (solicitada == CompuertaActiva::Vidrio) {
    servoCompuerta.write(kServoDerecha);
    mostrarLcd("Vidrio", "Girando derecha");
    informar(F("COMPUERTA: vidrio, gira a la derecha."));
  } else {
    servoCompuerta.write(kServoIzquierda);
    mostrarLcd("Plastico", "Girando izquierda");
    informar(F("COMPUERTA: plastico, gira a la izquierda."));
  }

  cancelarReposo();
  compuertaActiva = solicitada;
  cerrarCompuertaEn = millis() + kCompuertaAbiertaMs;
  mostrarCara(CaraReci::Feliz);
  return true;
}

void actualizarCompuerta() {
  if (compuertaActiva == CompuertaActiva::Ninguna) return;
  if (static_cast<long>(millis() - cerrarCompuertaEn) < 0) return;

  cerrarCompuertas();
  // El QR se queda kMostrarPremiosMs para que la persona lo escanee; después
  // actualizarReposo() vuelve al saludo.
  if (qrVisible) {
    mostrarLcd("Escanea tu QR", "para tus premios");
  } else {
    mostrarCara(CaraReci::Feliz);
    mostrarLcd("Gracias!", "Sigue reciclando");
  }
  programarReposo(kMostrarPremiosMs);
  informar(F("COMPUERTA: cerrada."));

  const Punto pendiente = destinoPendienteCompuerta;
  destinoPendienteCompuerta = Punto::Desconocido;
  if (pendiente != Punto::Desconocido) {
    informar(F("COMPUERTA: iniciando la ruta que estaba en espera."));
    irAPunto(pendiente);
  }
}

void iniciarPulsoAEsp(unsigned long duracion,
                      const __FlashStringHelper* etiqueta) {
  // D16 queda normalmente HIGH. El divisor 1k/2k entrega ~3.3 V al GPIO13.
  // Un pulso LOW no puede sobrepasar el voltaje permitido por la ESP32.
  digitalWrite(kMegaTx2Pin, LOW);
  pulsoMegaSalidaActivo = true;
  pulsoMegaSalidaDuracion = duracion;
  pulsoMegaSalidaEtiqueta = etiqueta;
  pulsoMegaSalidaTerminaEn = millis() + duracion;
}

void enviarPulsoAEsp(unsigned long duracion,
                     const __FlashStringHelper* etiqueta,
                     bool prioridad) {
  const unsigned long ahora = millis();
  if (!pulsoMegaSalidaActivo && !pulsoMegaSalidaPendiente &&
      static_cast<long>(ahora - pulsoMegaSalidaDisponibleEn) >= 0) {
    iniciarPulsoAEsp(duracion, etiqueta);
    return;
  }

  // Una confirmacion de compuerta puede reemplazar un evento informativo
  // pendiente, porque la ESP la necesita para registrar el reciclaje.
  if (!pulsoMegaSalidaPendiente || prioridad) {
    pulsoMegaSalidaPendiente = true;
    pulsoMegaPendienteDuracion = duracion;
    pulsoMegaPendienteEtiqueta = etiqueta;
    return;
  }

  Serial.println(F("RECI -> ESP: cola ocupada; pulso informativo omitido."));
}

void actualizarPulsoSalidaAEsp() {
  const unsigned long ahora = millis();
  if (pulsoMegaSalidaActivo &&
      static_cast<long>(ahora - pulsoMegaSalidaTerminaEn) >= 0) {
    digitalWrite(kMegaTx2Pin, HIGH);
    pulsoMegaSalidaActivo = false;
    pulsoMegaSalidaDisponibleEn = ahora + kSeparacionPulsoMegaMs;

    Serial.print(F("RECI -> ESP: pulso "));
    Serial.print(pulsoMegaSalidaEtiqueta);
    Serial.print(F(" de "));
    Serial.print(pulsoMegaSalidaDuracion);
    Serial.println(F(" ms."));
  }

  if (pulsoMegaSalidaActivo || !pulsoMegaSalidaPendiente ||
      static_cast<long>(ahora - pulsoMegaSalidaDisponibleEn) < 0) {
    return;
  }

  const unsigned long duracion = pulsoMegaPendienteDuracion;
  const __FlashStringHelper* etiqueta = pulsoMegaPendienteEtiqueta;
  pulsoMegaSalidaPendiente = false;
  iniciarPulsoAEsp(duracion, etiqueta);
}

void emitirLlegada(Punto punto) {
  if (punto == Punto::P1) {
    enviarPulsoAEsp(kPulsoMegaLlegadaP1Ms, F("LLEGADA P1"), false);
  } else if (punto == Punto::P2) {
    enviarPulsoAEsp(kPulsoMegaLlegadaP2Ms, F("LLEGADA P2"), false);
  }
  proximaPresenciaPermitidaEn = millis() + kEsperaPresenciaTrasLlegadaMs;
}

void actualizarPresencia() {
  const bool hayPresencia = digitalRead(kPirPin) == HIGH;
  if (!hayPresencia) {
    // Exigimos que el PIR vuelva a LOW antes de aceptar otra persona. Esto
    // evita iniciar varias clasificaciones mientras una misma señal sigue
    // activa durante varios segundos.
    pirListoParaNuevoEvento = true;
    return;
  }

  // Mientras haya alguien cerca, se sigue buscando la botella.
  if (static_cast<long>(millis() - buscarBotellaHasta) >= 0) {
    informar(F("BOTELLA: buscando (PIR)"));
  }
  buscarBotellaHasta = millis() + kBuscarBotellaTrasPirMs;

  if (modo != Modo::Detenido) return;
  if (compuertaActiva != CompuertaActiva::Ninguna) return;
  if (!pirListoParaNuevoEvento) return;
  if (static_cast<long>(millis() - proximaPresenciaPermitidaEn) < 0) return;

  pirListoParaNuevoEvento = false;
  proximaPresenciaPermitidaEn = millis() + kEsperaPresenciaMs;
  enviarPulsoAEsp(kPulsoMegaPresenciaMs, F("PRESENCIA"), false);
  informar(F("PRESENCIA: alguien se acerco"));
  if (!qrVisible) mostrarCara(CaraReci::Feliz);
  mostrarLcd("Hola, soy RECI", "Recicla aqui");
}

long medirDistanciaCm(uint8_t trig, uint8_t echo) {
  digitalWrite(trig, LOW);
  delayMicroseconds(2);
  digitalWrite(trig, HIGH);
  delayMicroseconds(10);
  digitalWrite(trig, LOW);

  const unsigned long duracion = pulseIn(echo, HIGH, kEchoTimeoutUs);
  if (duracion == 0) return -1;
  return static_cast<long>(duracion * 0.0343F / 2.0F);
}

long distanciaFrontalCm() {
  return medirDistanciaCm(kTrigFrontal, kEchoFrontal);
}

long distanciaBotellaCm() {
  return medirDistanciaCm(kTrigBotella, kEchoBotella);
}

// Con RECI quieto y la compuerta al centro, avisa por USB "BOTELLA:
// detectada" cuando un objeto se queda en el hueco. La compu toma las fotos
// al leer esa línea. Después exige que el hueco se vacíe antes de otra.
void actualizarBotella() {
  // En ruta no se mide: pulseIn bloquea hasta 25 ms y el freno frontal
  // tiene prioridad.
  if (modo != Modo::Detenido) {
    botellaPresenteDesde = 0;
    return;
  }
  const unsigned long ahora = millis();
  if (static_cast<long>(ahora - buscarBotellaHasta) >= 0) {
    botellaPresenteDesde = 0;
    return;
  }
  if (ahora - ultimoChequeoBotella < kRevisionBotellaMs) return;
  ultimoChequeoBotella = ahora;

  const long distancia = distanciaBotellaCm();
  const bool hayBotella = distancia >= kDistanciaBotellaMinCm &&
                          distancia <= kDistanciaBotellaCm;
  if (!hayBotella) {
    botellaPresenteDesde = 0;
    huecoVacioDesdeUltimaBotella = true;
    return;
  }

  if (compuertaActiva != CompuertaActiva::Ninguna) return;
  if (!huecoVacioDesdeUltimaBotella) return;
  if (static_cast<long>(ahora - proximaBotellaPermitidaEn) < 0) return;

  if (botellaPresenteDesde == 0) {
    botellaPresenteDesde = ahora;
    return;
  }
  if (ahora - botellaPresenteDesde < kBotellaEstableMs) return;

  botellaPresenteDesde = 0;
  huecoVacioDesdeUltimaBotella = false;
  proximaBotellaPermitidaEn = ahora + kEsperaEntreBotellasMs;
  Serial.print(F("RECI: BOTELLA: detectada a "));
  Serial.print(distancia);
  Serial.println(F(" cm"));
  cancelarReposo();
  mostrarCara(CaraReci::Movimiento);
  mostrarLcd("Analizando residuo", "No lo retires");
}

long distanciaTraseraCm() {
  return medirDistanciaCm(kTrigTrasero, kEchoTrasero);
}

bool rutaEnReversa = false;

// El freno usa el sensor que mira hacia donde se mueve RECI.
bool hayObstaculoEnSentido() {
  const long distancia = rutaEnReversa ? distanciaTraseraCm() : distanciaFrontalCm();
  return distancia > 0 && distancia <= static_cast<long>(kDistanciaSeguraCm);
}

void moverEnSentidoRuta() {
  if (rutaEnReversa) {
    retroceder();
  } else {
    avanzar();
  }
}

void detenerTodo(const __FlashStringHelper* motivo) {
  detenerMotores();
  destino = Punto::Desconocido;
  destinoPendienteCompuerta = Punto::Desconocido;
  modo = Modo::Detenido;
  mostrarCara(CaraReci::Lista);
  mostrarLcd("RECI detenido", "Listo para ti");
  informar(motivo);
}

bool tiemposConfigurados() {
  return kBaseAP1Ms > 0 && kP1AP2Ms > 0;
}

// Los puntos están en línea recta: BASE (0) - P1 (1) - P2 (2).
int8_t indicePunto(Punto punto) {
  switch (punto) {
    case Punto::Base: return 0;
    case Punto::P1: return 1;
    case Punto::P2: return 2;
    default: return -1;
  }
}

Punto puntoEnIndice(int8_t indice) {
  switch (indice) {
    case 0: return Punto::Base;
    case 1: return Punto::P1;
    case 2: return Punto::P2;
    default: return Punto::Desconocido;
  }
}

// Un tramo dura lo mismo en ambos sentidos: BASE-P1 o P1-P2.
unsigned long tiempoTramo(Punto desde, Punto hacia) {
  const int8_t menor = min(indicePunto(desde), indicePunto(hacia));
  if (menor == 0) return kBaseAP1Ms;
  if (menor == 1) return kP1AP2Ms;
  return 0;
}

Punto siguientePunto(Punto desde) {
  const int8_t paso = rutaEnReversa ? -1 : 1;
  return puntoEnIndice(indicePunto(desde) + paso);
}

void iniciarSiguienteTramo() {
  const Punto proximo = siguientePunto(puntoActual);
  if (proximo == Punto::Desconocido) {
    detenerTodo(F("FIN DE RUTA: no hay mas puntos en ese sentido"));
    return;
  }
  const unsigned long duracion = tiempoTramo(puntoActual, proximo);
  if (duracion == 0) {
    detenerTodo(F("ERROR: calibra T1 y T2 antes de usar P1/P2"));
    return;
  }
  moverEnSentidoRuta();
  terminaTramoEn = millis() + duracion;
  modo = Modo::EnRuta;
  mostrarCara(CaraReci::Movimiento);
  mostrarRutaEnLcd("Voy hacia", proximo);
  Serial.print(rutaEnReversa ? F("RECI: ruta en reversa ") : F("RECI: ruta "));
  Serial.print(nombrePunto(puntoActual));
  Serial.print(F(" -> "));
  Serial.println(nombrePunto(proximo));
}

void irAPunto(Punto solicitado) {
  if (puntoActual == Punto::Desconocido) {
    informar(F("ERROR: usa SET:BASE, SET:P1 o SET:P2 antes de una ruta"));
    return;
  }
  if (puntoActual == solicitado) {
    informarPunto(F("RECI ya esta en "), solicitado);
    mostrarRutaEnLcd("RECI ya esta en", solicitado);
    mostrarCara(CaraReci::Feliz);
    emitirLlegada(solicitado);
    return;
  }
  if (!tiemposConfigurados()) {
    informar(F("ERROR: primero calibra los tiempos T1/T2"));
    return;
  }
  if (compuertaActiva != CompuertaActiva::Ninguna) {
    destinoPendienteCompuerta = solicitado;
    detenerMotores();
    mostrarLcd("Cierro compuerta", "Ruta en espera");
    informar(F("SEGURIDAD: ruta en espera hasta cerrar la compuerta."));
    return;
  }

  destino = solicitado;
  rutaEnReversa = indicePunto(solicitado) < indicePunto(puntoActual);
  iniciarSiguienteTramo();
}

void actualizarRuta() {
  const unsigned long ahora = millis();

  // Pausa segura: RECI vuelve a andar solo cuando el ultrasónico lleva un
  // segundo entero sin ver ningún objeto a menos de 20 cm.
  if (modo == Modo::Emergencia) {
    if (hayObstaculoEnSentido()) {
      frenteLibreDesde = 0;
      return;
    }

    if (frenteLibreDesde == 0) {
      frenteLibreDesde = ahora;
      mostrarLcd("Camino libre", "Reanudo pronto");
      return;
    }

    if (ahora - frenteLibreDesde < kFrenteLibreAntesDeReanudarMs) return;

    terminaTramoEn = ahora + tiempoRestantePausaMs;
    frenteLibreDesde = 0;
    moverEnSentidoRuta();
    modo = Modo::EnRuta;
    mostrarCara(CaraReci::Movimiento);
    mostrarLcd("Ruta reanudada", "Sigo la ruta");
    informar(F("Ruta reanudada automaticamente."));
    return;
  }

  if (modo != Modo::EnRuta) return;

  if (ahora - ultimoChequeoObstaculo >= kRevisionObstaculoMs) {
    ultimoChequeoObstaculo = ahora;
    if (hayObstaculoEnSentido()) {
      detenerMotores();
      modo = Modo::Emergencia;
      tiempoRestantePausaMs =
          static_cast<long>(terminaTramoEn - ahora) > 0 ? terminaTramoEn - ahora : 0;
      frenteLibreDesde = 0;
      mostrarCara(CaraReci::Alerta);
      mostrarLcd("Obstaculo!", "Reanuda solo");
      informar(rutaEnReversa
                   ? F("EMERGENCIA: obstaculo trasero. Reanuda solo al despejar.")
                   : F("EMERGENCIA: obstaculo frontal. Reanuda solo al despejar."));
      return;
    }
  }

  if (static_cast<long>(ahora - terminaTramoEn) < 0) return;

  detenerMotores();
  puntoActual = siguientePunto(puntoActual);
  mostrarCara(CaraReci::Feliz);
  mostrarRutaEnLcd("Llegue a", puntoActual);
  emitirLlegada(puntoActual);
  informarPunto(F("Llegada estimada: "), puntoActual);

  if (puntoActual == destino) {
    destino = Punto::Desconocido;
    modo = Modo::Detenido;
    informar(F("RUTA COMPLETA"));
    return;
  }

  delay(250);  // pausa corta para estabilizar el chasis entre tramos.
  iniciarSiguienteTramo();
}

bool es(const char* texto, const char* esperado) {
  // Sin distinguir mayúsculas: "sensores?" funciona igual que "SENSORES?".
  return strcasecmp(texto, esperado) == 0;
}

bool empiezaCon(const char* texto, const char* prefijo) {
  return strncasecmp(texto, prefijo, strlen(prefijo)) == 0;
}

float leerPromedioAdc(uint8_t pin) {
  // Se descarta la primera lectura después de cambiar de canal ADC.
  static_cast<void>(analogRead(pin));
  delay(2);

  uint32_t suma = 0;
  for (uint8_t muestra = 0; muestra < kEspTxSenseSamples; ++muestra) {
    suma += static_cast<uint16_t>(analogRead(pin));
    delay(1);
  }
  return static_cast<float>(suma) / kEspTxSenseSamples;
}

void diagnosticarVoltajeEspTx() {
  const float lecturaGpio14 = leerPromedioAdc(kEspTxSensePin);
  const float lectura3v3 = leerPromedioAdc(kEsp3v3SensePin);
  if (lectura3v3 < 100.0F) {
    Serial.println(F("DIAG: falta conectar ESP 3V3 -> Mega A9."));
    return;
  }

  const float porcentaje3v3 = lecturaGpio14 * 100.0F / lectura3v3;

  Serial.print(F("DIAG GPIO14 A8="));
  Serial.print(lecturaGpio14, 0);
  Serial.print(F("/"));
  Serial.print(kAdcFullScale);
  Serial.print(F(" | ESP 3V3 A9="));
  Serial.print(lectura3v3, 0);
  Serial.print(F("/"));
  Serial.print(kAdcFullScale);
  Serial.print(F(" | GPIO14 equivale al "));
  Serial.print(porcentaje3v3, 0);
  Serial.println(F("% de 3V3"));
}

void rastrearSiA8SigueD16() {
  Serial.println(F("TRACE16 desactivado: D16 ahora envia pulsos a la ESP."));
}

bool permitirMovimientoManual() {
  if (compuertaActiva == CompuertaActiva::Ninguna) return true;

  detenerMotores();
  mostrarLcd("Cierra compuerta", "No puedo moverme");
  informar(F("SEGURIDAD: movimiento bloqueado; hay una compuerta abierta."));
  return false;
}

void procesarMensajeLcd(char* entrada) {
  // Formato enviado por la ESP32: CMD:LCD:linea 1|linea 2
  char* lineas = entrada + strlen("CMD:LCD:");
  char* separador = strchr(lineas, '|');
  if (separador == nullptr) {
    mostrarLcd(lineas, "");
    return;
  }
  *separador = '\0';
  mostrarLcd(lineas, separador + 1);
  programarReposo(kMostrarAvisoMs);
}

void procesarCaraEsp32(const char* entrada) {
  if (es(entrada, "CMD:FACE:happy")) {
    mostrarCara(CaraReci::Feliz);
  } else if (es(entrada, "CMD:FACE:thinking")) {
    mostrarCara(CaraReci::Movimiento);
  } else if (es(entrada, "CMD:FACE:confused")) {
    mostrarCara(CaraReci::Alerta);
  } else {
    // "idle" y cualquier valor futuro vuelven a la cara tranquila.
    mostrarCara(CaraReci::Lista);
  }
}

// Protocolo compacto ESP32 -> Mega. Cada orden actualiza una pantalla y la
// carita en una sola operación; evita enviar "CMD:FACE" y "CMD:LCD" seguidos
// mientras la OLED aún está redibujándose por I2C.
void mostrarSaludoEsp32(const char* nombre) {
  char linea1[17] = "Hola, ";
  if (nombre != nullptr && nombre[0] != '\0') {
    const size_t espacio = sizeof(linea1) - strlen(linea1) - 1;
    strncat(linea1, nombre, espacio);
  }
  mostrarCara(CaraReci::Lista);
  mostrarLcd(linea1, "Soy RECI");
}

bool procesarComandoCompacto(char* entrada) {
  if (es(entrada, "@S")) {
    mostrarCara(CaraReci::Lista);
    mostrarLcd("Hola, soy RECI", "Preparando camara");
  } else if (es(entrada, "@R")) {
    mostrarCara(CaraReci::Lista);
    mostrarLcd("Hola, soy Reci", "Envia C para leer");
  } else if (es(entrada, "@H")) {
    mostrarCara(CaraReci::Feliz);
    mostrarLcd("Hola, soy RECI", "Recicla y gana");
  } else if (es(entrada, "@B")) {
    mostrarCara(CaraReci::Lista);
    mostrarLcd("Ubica botella", "Frente a camara");
  } else if (es(entrada, "@A")) {
    cancelarReposo();
    mostrarCara(CaraReci::Movimiento);
    mostrarLcd("Analizando residuo", "No lo retires");
  } else if (es(entrada, "@U")) {
    mostrarCara(CaraReci::Alerta);
    mostrarLcd("No estoy seguro", "Intenta de nuevo");
    programarReposo(kMostrarAvisoMs);
  } else if (es(entrada, "@P")) {
    abrirCompuerta(CompuertaActiva::Plastico);
  } else if (es(entrada, "@V")) {
    abrirCompuerta(CompuertaActiva::Vidrio);
  } else if (es(entrada, "@L")) {
    mostrarLcd("Gracias!", "Puntos agregados");
  } else if (es(entrada, "@O")) {
    mostrarLcd("Gracias!", "Tapa abierta");
  } else if (empiezaCon(entrada, "@G:")) {
    mostrarSaludoEsp32(entrada + strlen("@G:"));
  } else if (empiezaCon(entrada, "@Q:")) {
    mostrarLcd("Escanea tu QR", "para tus premios");
    mostrarQrReal(entrada + strlen("@Q:"));
    programarReposo(kMostrarPremiosMs);
  } else {
    return false;
  }
  return true;
}

void procesarComando(char* entrada) {
  // Estos mensajes vienen de la ESP32-CAM. No mueven las ruedas; solo
  // actualizan las pantallas o abren una compuerta cuando RECI está quieto.
  if (procesarComandoCompacto(entrada)) {
    return;
  } else if (empiezaCon(entrada, "CMD:LCD:")) {
    procesarMensajeLcd(entrada);
  } else if (empiezaCon(entrada, "CMD:FACE:")) {
    procesarCaraEsp32(entrada);
  } else if (empiezaCon(entrada, "CMD:QR:")) {
    mostrarLcd("Escanea tu QR", "para tus premios");
    mostrarQrReal(entrada + strlen("CMD:QR:"));
    programarReposo(kMostrarPremiosMs);
  } else if (es(entrada, "PING")) {
    // Diagnóstico del regreso Mega -> ESP sin mover ni abrir nada.
    mostrarLcd("PULSO A ESP", "Enviando prueba");
    enviarPulsoAEsp(kPulsoMegaPongMs, F("PONG"), false);
  } else if (es(entrada, "VIDRIO") || es(entrada, "CMD:CLASSIFY:vidrio")) {
    abrirCompuerta(CompuertaActiva::Vidrio);
  } else if (es(entrada, "PLASTICO") || es(entrada, "CMD:CLASSIFY:plastico")) {
    abrirCompuerta(CompuertaActiva::Plastico);
  } else if (es(entrada, "F")) {
    if (!permitirMovimientoManual()) return;
    destino = Punto::Desconocido;
    avanzar();
    modo = Modo::ManualAdelante;
    mostrarCara(CaraReci::Movimiento);
    mostrarLcd("Modo manual", "Adelante");
    informar(F("Manual: adelante"));
  } else if (es(entrada, "B")) {
    if (!permitirMovimientoManual()) return;
    destino = Punto::Desconocido;
    retroceder();
    modo = Modo::ManualAtras;
    mostrarCara(CaraReci::Movimiento);
    mostrarLcd("Modo manual", "Atras");
    informar(F("Manual: atras"));
  } else if (es(entrada, "L")) {
    if (!permitirMovimientoManual()) return;
    destino = Punto::Desconocido;
    girarIzquierda();
    modo = Modo::ManualIzquierda;
    mostrarCara(CaraReci::Movimiento);
    mostrarLcd("Modo manual", "Izquierda");
    informar(F("Manual: izquierda"));
  } else if (es(entrada, "R")) {
    if (!permitirMovimientoManual()) return;
    destino = Punto::Desconocido;
    girarDerecha();
    modo = Modo::ManualDerecha;
    mostrarCara(CaraReci::Movimiento);
    mostrarLcd("Modo manual", "Derecha");
    informar(F("Manual: derecha"));
  } else if (es(entrada, "S")) {
    detenerTodo(F("DETENIDO"));
  } else if (es(entrada, "SET:BASE")) {
    puntoActual = Punto::Base;
    mostrarCara(CaraReci::Lista);
    mostrarLcd("Hola, soy RECI", "Estoy en BASE");
    informar(F("Posicion confirmada: BASE"));
  } else if (es(entrada, "SET:P1")) {
    puntoActual = Punto::P1;
    mostrarCara(CaraReci::Lista);
    mostrarLcd("Hola, soy RECI", "Estoy en P1");
    informar(F("Posicion confirmada: P1"));
  } else if (es(entrada, "SET:P2")) {
    puntoActual = Punto::P2;
    mostrarCara(CaraReci::Lista);
    mostrarLcd("Hola, soy RECI", "Estoy en P2");
    informar(F("Posicion confirmada: P2"));
  } else if (es(entrada, "P1")) {
    irAPunto(Punto::P1);
  } else if (es(entrada, "P2")) {
    irAPunto(Punto::P2);
  } else if (es(entrada, "BASE")) {
    irAPunto(Punto::Base);
  } else if (es(entrada, "RESUME")) {
    if (modo != Modo::Emergencia) {
      informar(F("No hay una emergencia activa."));
    } else if (hayObstaculoEnSentido()) {
      informar(F("El obstaculo sigue en el camino."));
    } else if (destino == Punto::Desconocido) {
      modo = Modo::Detenido;
      informar(F("No hay ruta pendiente."));
    } else {
      terminaTramoEn = millis() + tiempoRestantePausaMs;
      frenteLibreDesde = 0;
      moverEnSentidoRuta();
      modo = Modo::EnRuta;
      mostrarCara(CaraReci::Movimiento);
      mostrarLcd("Ruta reanudada", "Con cuidado");
      informar(F("Ruta reanudada."));
    }
  } else if (es(entrada, "V14")) {
    diagnosticarVoltajeEspTx();
  } else if (es(entrada, "TRACE16")) {
    rastrearSiA8SigueD16();
  } else if (es(entrada, "STATUS")) {
    informarPunto(F("Posicion: "), puntoActual);
    informarPunto(F("Destino: "), destino);
  } else if (es(entrada, "SENSORES?") || es(entrada, "SENSORES")) {
    const long frente = distanciaFrontalCm();
    const long atras = distanciaTraseraCm();
    const long botella = distanciaBotellaCm();
    Serial.print(F("RECI: frente="));
    Serial.print(frente);
    Serial.print(F(" cm  atras="));
    Serial.print(atras);
    Serial.print(F(" cm  botella="));
    Serial.print(botella);
    Serial.print(F(" cm  pir="));
    Serial.print(digitalRead(kPirPin) == HIGH ? F("HIGH") : F("LOW"));
    Serial.println(F("  (-1 = sin lectura)"));
  } else if (es(entrada, "BOTELLA?") || es(entrada, "BOTELLA")) {
    const long distancia = distanciaBotellaCm();
    Serial.print(F("RECI: sensor de botella = "));
    if (distancia < 0) {
      Serial.println(F("sin lectura. Revisa TRIG D24 / ECHO D25 / 5V / GND."));
    } else {
      Serial.print(distancia);
      Serial.println(F(" cm"));
    }
  } else if (es(entrada, "VEL?") || es(entrada, "VEL")) {
    informarPotencias();
  } else if (empiezaCon(entrada, "VEL:I:") || empiezaCon(entrada, "VEL:D:")) {
    // VEL:I:220 baja la rueda izquierda; VEL:D:220 la derecha. 255 = máximo.
    const int valor = atoi(entrada + strlen("VEL:I:"));
    if (valor < 60 || valor > 255) {
      informar(F("ERROR: potencia entre 60 y 255."));
      return;
    }
    if (toupper(entrada[4]) == 'I') {
      potenciaIzq = static_cast<uint8_t>(valor);
    } else {
      potenciaDer = static_cast<uint8_t>(valor);
    }
    guardarPotencias();
    informarPotencias();
  } else if (empiezaCon(entrada, "SERVO:")) {
    // Prueba de ángulo sin recargar: SERVO:150. Vuelve al centro con SERVO:90.
    if (modo != Modo::Detenido) {
      informar(F("Primero detén a RECI con S."));
      return;
    }
    const int angulo = atoi(entrada + strlen("SERVO:"));
    if (angulo < 0 || angulo > 180) {
      informar(F("ERROR: angulo entre 0 y 180."));
      return;
    }
    servoCompuerta.write(angulo);
    Serial.print(F("RECI: servo a "));
    Serial.print(angulo);
    Serial.println(F(" grados"));
  } else if (es(entrada, "MOTORES")) {
    if (modo != Modo::Detenido) {
      informar(F("Primero detén a RECI con S."));
      return;
    }
    if (!permitirMovimientoManual()) return;
    probarMotores();
  } else if (es(entrada, "HELP")) {
    Serial.println(F("F B L R S | SET:BASE/P1/P2 | P1 P2 | VIDRIO PLASTICO | MOTORES BOTELLA? SENSORES? SERVO:n VEL? VEL:I:n VEL:D:n | BASE | V14 TRACE16 | STATUS"));
  } else {
    informar(F("ERROR: comando invalido. Escribe HELP."));
  }
}

bool coincidePulsoEsp(unsigned long duracion, unsigned long esperado) {
  const unsigned long minimo = esperado > kToleranciaPulsoMs
      ? esperado - kToleranciaPulsoMs
      : 0;
  return duracion >= minimo && duracion <= esperado + kToleranciaPulsoMs;
}

void iniciarRecepcionCodigoQr() {
  recibiendoCodigoQr = true;
  longitudCodigoQrRecibido = 0;
  codigoQrRecibido[0] = '\0';
  ultimoCaracterQrEn = millis();
  mostrarCara(CaraReci::Lista);
  mostrarLcd("Generando QR", "Espera un poco");
  informar(F("QR: inicio de codigo recibido."));
}

void cancelarRecepcionCodigoQr(const __FlashStringHelper* motivo) {
  recibiendoCodigoQr = false;
  longitudCodigoQrRecibido = 0;
  codigoQrRecibido[0] = '\0';
  mostrarCara(CaraReci::Alerta);
  mostrarLcd("QR no valido", "Intenta de nuevo");
  informar(motivo);
}

bool decodificarCaracterQr(unsigned long duracion, char& caracter) {
  if (duracion + kToleranciaQrCaracterMs < kPulsoQrCaracterBaseMs) return false;

  const unsigned long ajustado = duracion - kPulsoQrCaracterBaseMs;
  const uint8_t indice = static_cast<uint8_t>(
      (ajustado + (kPulsoQrCaracterPasoMs / 2)) / kPulsoQrCaracterPasoMs);
  const uint8_t totalCaracteres = sizeof(kAlfabetoCodigoQr) - 1;
  if (indice >= totalCaracteres) return false;

  const unsigned long esperado = kPulsoQrCaracterBaseMs +
      static_cast<unsigned long>(indice) * kPulsoQrCaracterPasoMs;
  const unsigned long diferencia = duracion > esperado
      ? duracion - esperado
      : esperado - duracion;
  if (diferencia > kToleranciaQrCaracterMs) return false;

  caracter = kAlfabetoCodigoQr[indice];
  return true;
}

void recibirCaracterCodigoQr(unsigned long duracion) {
  char caracter = '\0';
  if (!decodificarCaracterQr(duracion, caracter)) {
    cancelarRecepcionCodigoQr(F("QR: pulso de caracter invalido."));
    return;
  }

  codigoQrRecibido[longitudCodigoQrRecibido++] = caracter;
  codigoQrRecibido[longitudCodigoQrRecibido] = '\0';
  ultimoCaracterQrEn = millis();

  if (longitudCodigoQrRecibido < kLongitudCodigoQr) return;

  recibiendoCodigoQr = false;
  mostrarQrReal(codigoQrRecibido);
  mostrarLcd("Escanea tu QR", "para tus premios");
  programarReposo(kMostrarPremiosMs);
  Serial.print(F("QR: codigo real listo: "));
  Serial.println(codigoQrRecibido);
}

void actualizarRecepcionCodigoQr() {
  if (!recibiendoCodigoQr) return;
  if (millis() - ultimoCaracterQrEn <= kTimeoutRecepcionQrMs) return;
  cancelarRecepcionCodigoQr(F("QR: tiempo agotado al recibir codigo."));
}

void procesarPulsoEsp(unsigned long duracion) {
  // Mientras se reciben los ocho símbolos QR, estas duraciones no son
  // comandos normales: son caracteres 0-9/A-Z.
  if (recibiendoCodigoQr) {
    recibirCaracterCodigoQr(duracion);
    return;
  }

  Serial.print(F("RECI: pulso ESP de "));
  Serial.print(duracion);
  Serial.println(F(" ms."));

  if (coincidePulsoEsp(duracion, kPulsoQrInicioMs)) {
    iniciarRecepcionCodigoQr();
  } else if (coincidePulsoEsp(duracion, kPulsoAnalizarMs)) {
    cancelarReposo();
    mostrarCara(CaraReci::Movimiento);
    mostrarLcd("Analizando residuo", "No lo retires");
  } else if (coincidePulsoEsp(duracion, kPulsoDesconocidoMs)) {
    mostrarCara(CaraReci::Alerta);
    mostrarLcd("No estoy seguro", "Intenta de nuevo");
    programarReposo(kMostrarAvisoMs);
  } else if (coincidePulsoEsp(duracion, kPulsoPlasticoMs)) {
    if (abrirCompuerta(CompuertaActiva::Plastico)) {
      delay(kRetrasoConfirmacionCompuertaMs);
      enviarPulsoAEsp(kPulsoMegaCompuertaConfirmadaMs,
                      F("COMPUERTA PLASTICO CONFIRMADA"), true);
    }
  } else if (coincidePulsoEsp(duracion, kPulsoVidrioMs)) {
    if (abrirCompuerta(CompuertaActiva::Vidrio)) {
      delay(kRetrasoConfirmacionCompuertaMs);
      enviarPulsoAEsp(kPulsoMegaCompuertaConfirmadaMs,
                      F("COMPUERTA VIDRIO CONFIRMADA"), true);
    }
  } else if (coincidePulsoEsp(duracion, kPulsoP1Ms)) {
    irAPunto(Punto::P1);
  } else if (coincidePulsoEsp(duracion, kPulsoP2Ms)) {
    irAPunto(Punto::P2);
  } else if (coincidePulsoEsp(duracion, kPulsoSaludoMs)) {
    mostrarCara(CaraReci::Feliz);
    mostrarLcd("Hola, soy RECI", "Recicla y gana");
  } else if (coincidePulsoEsp(duracion, kPulsoBotellaMs)) {
    mostrarCara(CaraReci::Lista);
    mostrarLcd("Ubica botella", "Frente a camara");
  } else if (coincidePulsoEsp(duracion, kPulsoListoMs)) {
    mostrarCara(CaraReci::Lista);
    mostrarLcd("Hola, soy RECI", "Listo para usar");
  } else if (coincidePulsoEsp(duracion, kPulsoErrorMs)) {
    mostrarCara(CaraReci::Alerta);
    mostrarLcd("Error de ESP", "Revisa camara");
  } else if (coincidePulsoEsp(duracion, kPulsoPuntosDirectosMs)) {
    mostrarCara(CaraReci::Feliz);
    mostrarLcd("Gracias!", "Puntos agregados");
  } else if (coincidePulsoEsp(duracion, kPulsoPuntosAppMs)) {
    mostrarCara(CaraReci::Lista);
    mostrarLcd("Abre la app", "Para tus puntos");
  } else if (coincidePulsoEsp(duracion, kPulsoGraciasMs)) {
    mostrarCara(CaraReci::Feliz);
    mostrarLcd("Gracias!", "Sigue reciclando");
    programarReposo(kMostrarAvisoMs);
  } else if (coincidePulsoEsp(duracion, kPulsoPruebaMs)) {
    mostrarLcd("PULSO ESP", "Mega recibe OK");
    informar(F("PULSO ESP -> Mega OK."));
  } else {
    informar(F("PULSO ESP desconocido; ignorado."));
  }
}

void actualizarPulsoEsp() {
  const bool nivelAlto = digitalRead(kPulsoEspPin) == HIGH;
  const unsigned long ahora = millis();

  // GPIO14 puede emitir niveles transitorios al arrancar la ESP32-CAM. Se
  // ignoran los primeros segundos para que nunca se interpreten como ruta o
  // apertura de compuerta.
  if (static_cast<long>(ahora - habilitarPulsosEspEn) < 0) {
    pulsoEspActivo = nivelAlto;
    finPulsoEspPendiente = false;
    if (nivelAlto) inicioPulsoEspEn = ahora;
    return;
  }

  if (nivelAlto && !pulsoEspActivo) {
    pulsoEspActivo = true;
    finPulsoEspPendiente = false;
    inicioPulsoEspEn = ahora;
    return;
  }

  if (nivelAlto && pulsoEspActivo) {
    // Si D17 vuelve a HIGH antes del filtro, fue ruido y el pulso original
    // sigue activo desde su primer flanco.
    finPulsoEspPendiente = false;
    return;
  }

  if (!nivelAlto && pulsoEspActivo && !finPulsoEspPendiente) {
    finPulsoEspPendiente = true;
    inicioFinPulsoEspEn = ahora;
    return;
  }

  const unsigned long finEstableMs = recibiendoCodigoQr
      ? kFinPulsoQrEstableMs
      : kFinPulsoEspEstableMs;
  if (!nivelAlto && pulsoEspActivo && finPulsoEspPendiente &&
      ahora - inicioFinPulsoEspEn >= finEstableMs) {
    pulsoEspActivo = false;
    finPulsoEspPendiente = false;
    if (inicioPulsoEspEn < habilitarPulsosEspEn) return;
    procesarPulsoEsp(inicioFinPulsoEspEn - inicioPulsoEspEn);
  }
}

void leerSerial(Stream& puerto, EntradaSerial& entrada) {
  while (puerto.available() > 0) {
    const char caracter = static_cast<char>(puerto.read());
    if (caracter == '\r') continue;
    if (caracter == '\n') {
      if (!entrada.descartarHastaNuevaLinea && entrada.longitud > 0) {
        entrada.comando[entrada.longitud] = '\0';
        procesarComando(entrada.comando);
      }
      entrada.longitud = 0;
      entrada.descartarHastaNuevaLinea = false;
      continue;
    }
    if (entrada.descartarHastaNuevaLinea) continue;
    if (entrada.longitud >= kComandoMax) {
      entrada.longitud = 0;
      entrada.descartarHastaNuevaLinea = true;
      informar(F("ERROR: comando demasiado largo; trama descartada."));
      continue;
    }
    entrada.comando[entrada.longitud++] = caracter;
  }
}

}  // namespace

void setup() {
  Serial.begin(kUsbSerialBaud);
  delay(250);
  Serial.println(F("BOOT: Mega iniciado a 9600 baud."));
  Serial.println(F("POSICION INICIAL: BASE (modo demo)."));
  Serial.flush();
  pinMode(SDA, INPUT_PULLUP);
  pinMode(SCL, INPUT_PULLUP);
  delay(5);
  diagnosticarLineasI2c(F("al inicio"));
  // Comunicación bidireccional robusta por pulsos:
  //   ESP GPIO14 -> Mega D17 (HIGH)
  //   Mega D16 -> divisor -> ESP GPIO13 (LOW)
  pinMode(kMegaTx2Pin, OUTPUT);
  digitalWrite(kMegaTx2Pin, HIGH);
  pinMode(kPulsoEspPin, INPUT);
  habilitarPulsosEspEn = millis() + kIgnorarPulsosAlArrancarMs;
  Serial.println(F("PASO 1: pulsos bidireccionales iniciados."));
  Serial.println(F("MODO: GPIO14->D17 y D16->GPIO13 por pulsos."));
  diagnosticarLineasI2c(F("despues de Serial2"));

  const uint8_t pinesMotor[] = {kIzqIn1, kIzqIn2, kIzqIn3, kIzqIn4,
                                kDerIn1, kDerIn2, kDerIn3, kDerIn4};
  for (uint8_t pin : pinesMotor) pinMode(pin, OUTPUT);
  detenerMotores();
  cargarPotencias();
  Serial.println(F("PASO 2: motores detenidos."));
  informarPotencias();
  diagnosticarLineasI2c(F("despues de motores"));

  pinMode(kTrigFrontal, OUTPUT);
  pinMode(kEchoFrontal, INPUT);
  digitalWrite(kTrigFrontal, LOW);
  pinMode(kTrigTrasero, OUTPUT);
  pinMode(kEchoTrasero, INPUT);
  digitalWrite(kTrigTrasero, LOW);
  pinMode(kTrigBotella, OUTPUT);
  pinMode(kEchoBotella, INPUT);
  digitalWrite(kTrigBotella, LOW);
  pinMode(kPirPin, INPUT);
  proximaPresenciaPermitidaEn = millis() + kPirWarmupMs;
  Serial.println(F("PASO 3: sensores configurados."));
  diagnosticarLineasI2c(F("despues de sensores"));

  Serial.println(F("PASO 4: iniciando servo de compuerta."));
  servoCompuerta.attach(kServoCompuertaPin);
  diagnosticarLineasI2c(F("despues de servo compuerta"));
  cerrarCompuertas();
  Serial.println(F("PASO 5: servo en el centro."));
  diagnosticarLineasI2c(F("despues de cerrar servos"));

  Serial.println(F("PASO 6: iniciando bus I2C."));
  pinMode(SDA, INPUT_PULLUP);
  pinMode(SCL, INPUT_PULLUP);
  delay(5);
  diagnosticarLineasI2c(F("antes de Wire"));
  Wire.begin();
  Wire.setWireTimeout(kI2cTimeoutUs, true);
  Wire.setClock(kI2cClockHz);
  delay(5);
  diagnosticarLineasI2c(F("despues de Wire"));
  Serial.println(F("PASO 7: buscando OLED en 0x3C."));
  if (i2cResponde(kDireccionOled)) {
    Serial.println(F("PASO 8: OLED detectada; iniciando."));
    oledDisponible = oled.begin(SSD1306_SWITCHCAPVCC, kDireccionOled);
    if (oledDisponible) {
      mostrarCara(CaraReci::Lista);
      Serial.println(F("OLED: carita RECI lista."));
    } else {
      Serial.println(F("AVISO: OLED detectada pero no pudo iniciar."));
    }
  } else {
    // El robot sigue operativo aunque la pantalla se desconecte.
    Serial.println(F("AVISO: OLED no encontrada en 0x3C."));
  }

  if (i2cResponde(kDireccionLcd)) {
    lcd.init();
    lcd.backlight();
    lcdDisponible = true;
    mostrarLcd("Hola, soy RECI", "Estoy listo");
    Serial.println(F("LCD: lista en 0x27."));
  } else {
    Serial.println(F("AVISO: LCD no encontrada en 0x27."));
  }

  Serial.println(F("RECI Ruta Demo lista. El robot esta detenido."));
  Serial.println(F("VERSION: OLED + LCD + AUTO-REANUDAR v2"));
  Serial.println(F("Primero: SET:BASE. Luego: F/B/L/R/S o P1/P2."));
  Serial.println(F("Ajusta T1/T2 antes de usar la ruta recta."));
}

void loop() {
  leerSerial(Serial, entradaUsb);  // Pruebas por USB / Monitor Serial.
  actualizarPulsoSalidaAEsp();      // Mega D16 -> ESP GPIO13, sin bloquear.
  if (kEsp32CamConectada) {
    actualizarPulsoEsp();           // ESP GPIO14 -> Mega D17, sin UART.
    actualizarRecepcionCodigoQr();  // Completa o cancela un QR incompleto.
  }
  actualizarRuta();
  actualizarPresencia();
  actualizarBotella();
  actualizarCompuerta();
  actualizarReposo();
}
