PaulaMarquezM/Reci/(commit log)

2026-07-20 antes de entrenar
2026-07-23 Reorganizar como monorepo: integrar RECI2 (web, firmware, servicios cloud)
    Consolida RECI (prototipo de IA) y RECI2 (producto: PWA Next.js, Supabase,
    servicios cloud de visión/rostro, firmware ESP32-CAM/Arduino) en un solo
    repositorio, preservando el historial completo de ambos.
    - web/, firmware/, services/vision/, services/face/, docs/product/ importados
    desde RECI2 sin duplicar código.
    - services/vision/cloud_classifier.py consume expert_system/ y vision/ de la
    raíz como fuente única (ver docs/MONOREPO.md), reemplazando la copia
    duplicada que tenía RECI2.
    - web/.env.example documenta las variables requeridas por la app (Supabase,
    ROBOT_API_KEY, VISION_SERVICE_*, FACE_SERVICE_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
2026-08-12 feat: integrar operacion completa de RECI
2026-08-12 feat: desplegar app y habilitar HTTPS en ESP32
2026-08-13 feat(web): propagar votos del servicio de vision
2026-08-14 feat(vision): unificar la decision con seis votos
    Suma los tres diagnósticos de OpenAI+sistema experto y los tres del modelo local, tratando desconocido como abstención.
    Resuelve empates con la preferencia del proveedor y permite decidir sin OpenAI únicamente cuando el modelo local es unánime 3/3. Mantiene respuesta incompleta o confusión sin resolver como desconocido y evita CMD:CLASSIFY en esos rechazos.
    Replica la misma política en Python y ESP32-CAM, añade casos de prueba y expone la política activa en salud y monitor serie.
    [ReciEsp32Cam.ino]
2026-08-14 feat(modelo): activar MobileNetV2 validado en OV3660
    Promueve MobileNetV2 float32 como modelo local activo tras alcanzar 71.60% de exactitud y 71.25% de macro-F1 sobre 1000 imágenes QVGA de la cámara operativa.
    Conserva MobileNetV3-Large INT8 con sus manifiestos como respaldo auditable, actualiza hashes y metadatos, y ajusta el comparador para evaluar ambos modelos sin sustituir artefactos.
    Añade el análisis reproducible y una prueba que verifica arquitectura activa, SHA-256, forma 224x224 y tensores float32.
2026-08-14 feat: completar flujo autonomo de llamadas y reciclaje
2026-08-14 fix: estabilizar flujo autonomo de reciclaje
    [ReciEsp32Cam.ino, ReciRutaDemo.ino, RobotCallDispatcher.h]
2026-10-27 feat: compuerta de un solo servo y camara de la compu en lugar de la ESP32-CAM
    - ReciRutaDemo: un servo en D3 inclina la bandeja (plastico izquierda,
    vidrio derecha) y vuelve al centro tras 2 s.
    - ReciRutaDemo: kEsp32CamConectada = false deja de leer D17 para que el
    pin flotante no genere ordenes falsas sin la ESP32-CAM.
    - ReciServosTest: prueba y calibracion por angulo del servo unico.
    - camara-pc/: puente en Python (webcam + Reci Cloud + USB al Mega) que
    reemplaza a la ESP32-CAM, incluidas las llamadas desde la app.
2026-10-27 fix(motores): sentido por motor y prueba MOTORES para diagnosticar ruedas
    La rueda trasera derecha (D11/D13) giraba hacia atras con F; ahora cada par
    de pines tiene su propia constante de inversion. MOTORES mueve cada par por
    separado para identificar que rueda controla y detectar canales sin giro.
2026-10-27 fix(motores): invertir sentido de D9/D10
2026-10-27 fix(motores): D9/D10 vuelve a invertido tras recablear el motor
2026-10-27 feat(camara-pc): guardar metricas de cada lectura en metricas.csv
2026-10-27 feat: detectar la botella con el ultrasonico interno y disparar la foto
    - Mega: HC-SR04 en D24/D25 mira el hueco; con RECI detenido, un objeto
    quieto 0.8 s a <=15 cm imprime BOTELLA: detectada. Comando BOTELLA?
    para calibrar la distancia.
    - camara-pc: clasifica al leer BOTELLA en lugar del temporizador del PIR;
    el PIR queda solo para saludar.
2026-10-28 feat(ruta): regresar a BASE (y entre puntos) en reversa con freno trasero
    RECI no gira: hacia un punto anterior retrocede por la misma linea. En
    reversa el freno usa el tercer HC-SR04 montado atras (D26/D27); RESUME y
    la reanudacion automatica respetan el sentido. SENSORES? muestra las tres
    distancias para calibrar.
2026-10-28 feat(camara-pc): politica hibrida proveedor + modelo local
    Usa los vision_votes de cada foto igual que la ESP32-CAM: mayoria 2/3 del
    proveedor; con un solo voto del proveedor, el modelo local debe respaldarlo
    2/3; si el proveedor se abstiene, decide la mayoria local.
2026-10-28 fix(serial): comandos sin distinguir mayusculas y SENSORES/BOTELLA sin '?'
2026-10-28 feat(firmware): autocalibrar sensor de botella y comando SERVO:n
    El hueco vacio media 15-16 cm y el umbral fijo de 15 cm daba falsas
    detecciones. Ahora se mide al arrancar (o con CALIBRAR) y se detecta 4 cm
    por debajo. SERVO:n prueba angulos sin recargar el sketch.
2026-10-28 fix(firmware): D9/D10 sin invertir y servo centrado en 60
2026-10-28 fix(servo): reposo en 65 y giro de 35 grados por lado
2026-10-28 feat(firmware): buscar botella solo tras PIR, umbral fijo 10 cm
    La autocalibracion fallaba si al arrancar habia una botella en el hueco.
2026-11-05 fix(vision): no convertir carton ni papel en lata con la heuristica de metal
    OpenAI reconocia el carton, pero la heuristica de OpenCV de "metal mate"
    (poca saturacion, poco brillo) lo cambiaba a lata. El veto de OpenAI ahora
    tambien revoca ese cambio para carton, vaso de carton, Tetra Pak, papel y
    organicos, igual que ya hacia con botellas PET.
2026-11-05 fix(camara-pc): decidir solo con mayoria del proveedor; lata y organico como resultado
    - Si el sistema experto concluye LATA u ORGANICO en 2 de 3 fotos, el
    resultado es "lata" u "organico": no abre compuerta y la LCD lo avisa.
    - Si el proveedor dice desconocido en 2 o mas fotos, el resultado es
    desconocido. El modelo local queda solo como diagnostico: al ser binario
    convertia en plastico latas y papel que el proveedor rechazaba.
2026-11-08 fix(sistema-experto): quitar 4 reglas con condiciones duplicadas
    Con CF MYCIN las reglas con condiciones identicas contaban la misma
    evidencia dos veces e inflaban la certeza. Se conserva la de mayor CF
    de cada par (R61, R67_V, R111, R114). Quedan 189 reglas; 118/118 pruebas.
2026-11-08 fix(vision): vidrio reconocido por OpenAI ya no se vuelve lata; reglas de confianza media
    - La heuristica de metal marcaba como lata un frasco de vidrio sobre la mesa
    beige de la webcam (baja saturacion). Si OpenAI ve un objeto de vidrio, el
    veto conserva su lectura, igual que con carton y PET.
    - 15 objetos del nivel 1 solo tenian regla con confianza alta; con media no
    disparaba nada. Se agregan R02_B..R17_B (CF 0.85-0.88).
    - camara-pc/probar_sin_mega.py: probar la clasificacion solo con la camara,
    sin Arduino y sin registrar reciclajes.
2026-11-08 feat(vision): devolver los atributos del sistema experto en /api/vision/classify
    Permite ver desde camara-pc que atributos vio el proveedor en cada foto y
    diagnosticar fallos con datos reales. Solo texto (9 atributos), sin imagen.
2026-11-08 fix(sistema-experto): frasco de vidrio con tapa plastica es vidrio
    Con atributos reales de la webcam (frasco_vidrio, brillo alto_nitido, tapa
    rosca_plastico) R60/R109 ganaban por la tapa: 0.989 plastico vs 0.974 vidrio.
    R04_C: la tapa no define el material del cuerpo. Casos T200/T201 con los
    atributos reales. probar_sin_mega.py muestra y guarda los atributos.
2026-11-08 fix(vision): fondo claro ya no inventa latas; frascos gotero ambar son vidrio
    - Con la webcam OpenCV no recorta el objeto (contour_area_pct ~0) y las
    senales de metal salen del fondo: una hoja blanca parece aluminio. La
    heuristica solo puede convertir en lata lo que OpenAI vio como botella o
    desconocido; funda, vaso, plato o frasco se conservan.
    - R04_D (frasco_vidrio ambar) y R01_C (mocachino con rosca plastica): frascos
    gotero de vidrio ambar terminaban en PLASTICO por la tapa gotero (R109).
    - Casos T202-T204 con atributos reales. 207 reglas, 123/123 pruebas.
2026-11-08 feat(firmware): pantalla vuelve sola al saludo; QR 10 s y 'Escanea tu QR'
    - Tras reciclar: LCD 'Escanea tu QR / para tus premios' y QR en la OLED
    durante 10 s; luego vuelve a 'Hola, soy RECI'. Ya no dice 'Tapa cerrada'.
    - 'No estoy seguro' y rechazos (CMD:LCD) vuelven al saludo a los 5 s.
    - Espera entre botellas: 10 s (antes 8 s).
2026-11-08 feat(vision): devolver atributos originales del proveedor para diagnostico
    /v1/classify y /api/vision/classify incluyen atributos_proveedor (antes de
    OpenCV y del veto). probar_sin_mega.py muestra que cambio la heuristica, para
    saber si una 'lata' falsa la dice OpenAI o la heuristica de metal.
2026-11-08 fix(vision): solo OpenAI puede concluir lata; la heuristica ya no la inventa
    Con atributos_proveedor se comprobo que en 18 consultas OpenAI nunca dijo
    lata: todas las latas falsas salian de OpenCV, que con esta camara mide el
    fondo claro (contour_area_pct ~0). Si OpenAI dice desconocido el robot igual
    rechaza; si dice botella o frasco, se conserva su lectura.
2026-11-08 fix(sistema-experto): frasco de vidrio con brillo nitido es vidrio (R04_E)
    Con confianza media R04_B (0.87) quedaba bajo el umbral del backward y un
    frasco de vidrio sin tapa se rechazaba. Caso T205 con atributos reales.
    208 reglas, 124/124 pruebas.
2026-11-08 feat(camara-pc): recortar la foto a la bandeja (RECI_RECORTE)
    Con la camara pegada se ve tambien el fondo (pared, tacho, cables) y eso
    confunde al proveedor. RECI_RECORTE=x1,y1,x2,y2 en fracciones recorta la foto
    antes de clasificar; la vista previa dibuja el rectangulo. Vacio = imagen
    completa.
2026-11-08 fix(firmware): sensor de botella en D26/D27, umbral 20 cm, compuerta 20/110
    Prueba con el robot (2026-11-08): el ultrasonico del hueco estaba cableado en
    D26/D27 (el firmware lo buscaba en D24/D25) y mide ~28 cm vacio. La
    compuerta a 30/100 grados a veces no movia la bandeja; 20/110 gira bien.
2026-11-08 fix(firmware): sensor de botella en D24/D25 con umbral 8 cm; PIR en SENSORES
    Prueba del 2026-11-08: hueco vacio mide ~11 cm y una botella acostada
    ~5 cm, asi que 20 cm disparaba fotos con el hueco vacio. SENSORES ahora
    muestra tambien el estado del PIR (HIGH/LOW).
2026-11-08 fix(camara-pc): retomar llamadas in_progress y cerrar las de un punto donde ya esta
    Una llamada a Base con RECI ya en Base quedaba in_progress para siempre:
    el Mega responde "RECI ya esta en BASE" (no "Llegada estimada") y el
    programa ignoraba las in_progress que devuelve /next, asi que bloqueaba
    toda la cola de llamadas.
2026-11-08 feat(firmware): potencia PWM por lado (VEL:I:n / VEL:D:n) guardada en EEPROM
    RECI se desviaba a la derecha porque los motores no giran igual. Ahora
    cada lado se puede bajar por serial sin recargar; con izq=220 der=255 va
    recto (prueba 2026-11-08).
